mjj4791/blind/img/config.png

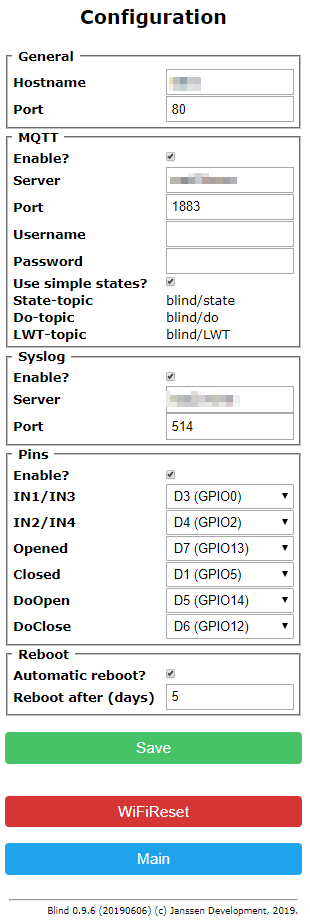
img/config.png
