mjj4791/blind/img/schematic.png

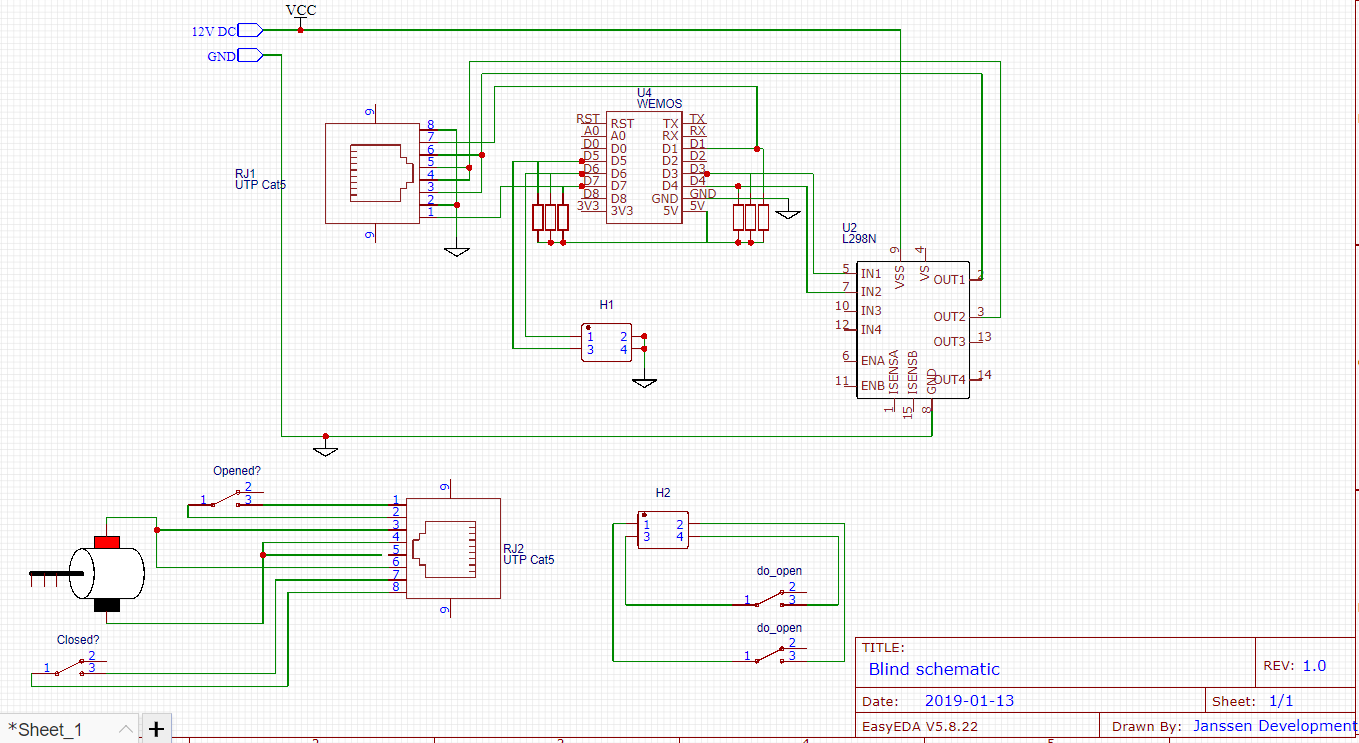
img/schematic.png
