mjj4791/blind/img/State.png

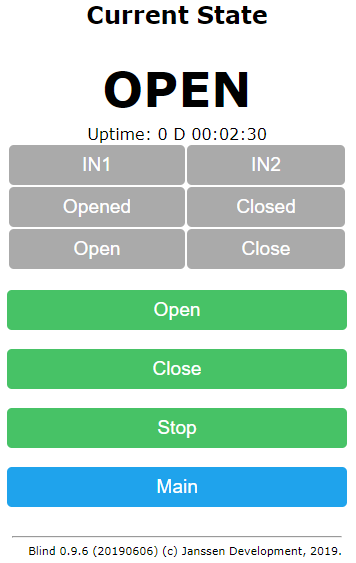
img/State.png
