mjj4791/blind/img/state_diagram.png

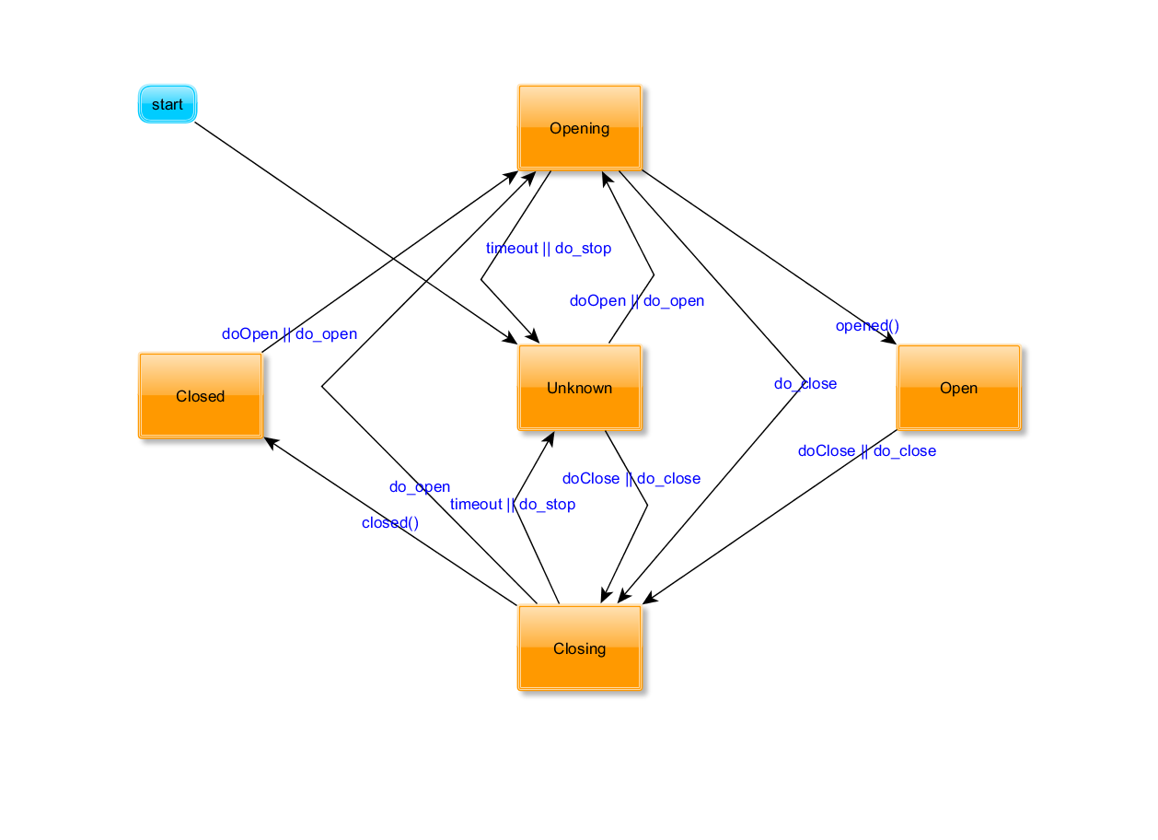
img/state_diagram.png
