mjj4791/blind/(commit log)

2019-01-13 Debounce / hostname / lastConnectAttempt
    Version 0.9.3/20190108
    Use DebouncedSwitch library for debounding and EMI prevention.
    Store lastConnectAttempt time at the end of the PubSubClient connect attempt
    Correctly set and use hostname for dhcp / WiFi access
    [blind.ino]
2019-02-10 Resend LWT to prevent device remaining offline
    Resend LWT to prevent device remaining offline
    [blind.ino]
